DENJU-DIVISION/Tei-Board/README.md

# Tei board 帝
The Tei Board is a PCB designed mainly for minisumo robots, but it can be used for other projects or categories.\
It's a simple begginer-level PCB, uses mostly SMD components that are easy to find and solder, so it should be really simple to build.\
The processor is a Arduino Nano, and the motor driver is the TB6612FNG both very cheap and easy to find components.\
It's designed to support up to 15V but we recomend using a maximum of 3S batteries.\
This board is perfect for those just starting in robotics, easy to program and has a lot of capabilities. We recommend the use of this board for amateur categories of minisumo or line followers.\
# Features
- Dedicated bluetooth pin, so you can hook up a reciever module and control your projects remotely
- Dedicated Start Module pin
- Capability to connect up to 8 sensors, 6 of them supporting both analog and digital signals (the remaining 2 only support analog inputs)
- Rotary switch to select your programs
- XT30 connector
- On/Off Switch
- M2 mounting holes for secure mounting
- XH connectors for the motors
# Photos
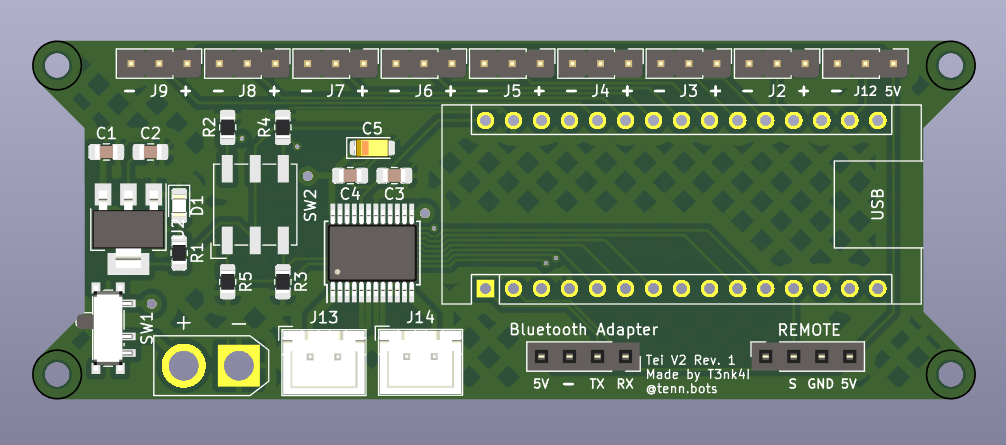
[picture p1: Tei Board front.png]

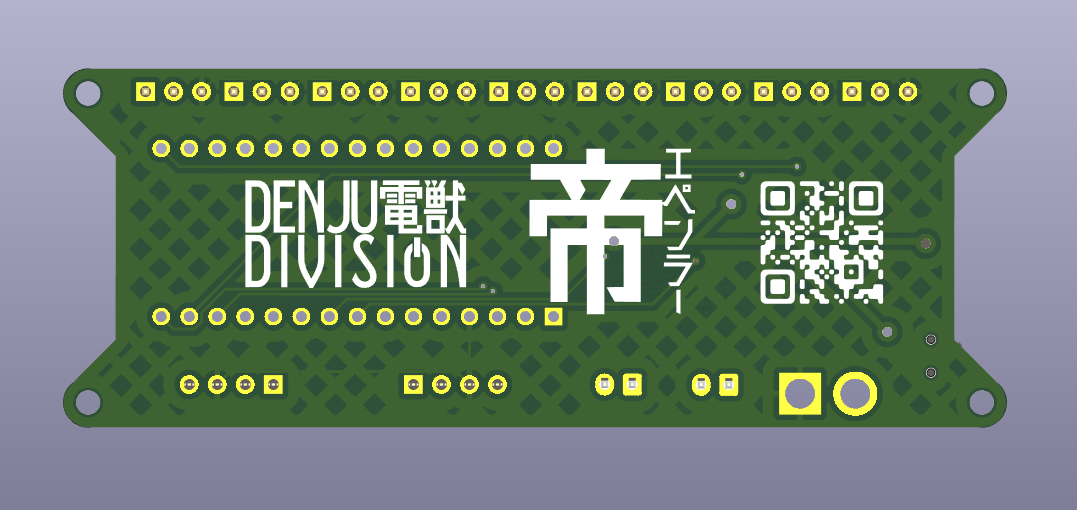
[picture p2: Tei Board back.png]
