DENJU-DIVISION/Tei-Board/Tei/Description.md

# 帝 Tei board

This is Tei (帝) Board, uses a arduino Uno and a TB6612FNG motor driver.\
Works up to 3s LiPo Batteries, (2S-3S reccomended).\
Supports up to 10 different porgrams using the included rotary coded switch.\
Example code can be found in "https://github.com/T3nk4I/Minisumo/tree/main/code/Basic".
