DENJU-DIVISION/Tei-Board/Tei/Tei.kicad_pcb

## KiCad design Tei/Tei.kicad_pcb (2025-02-03)

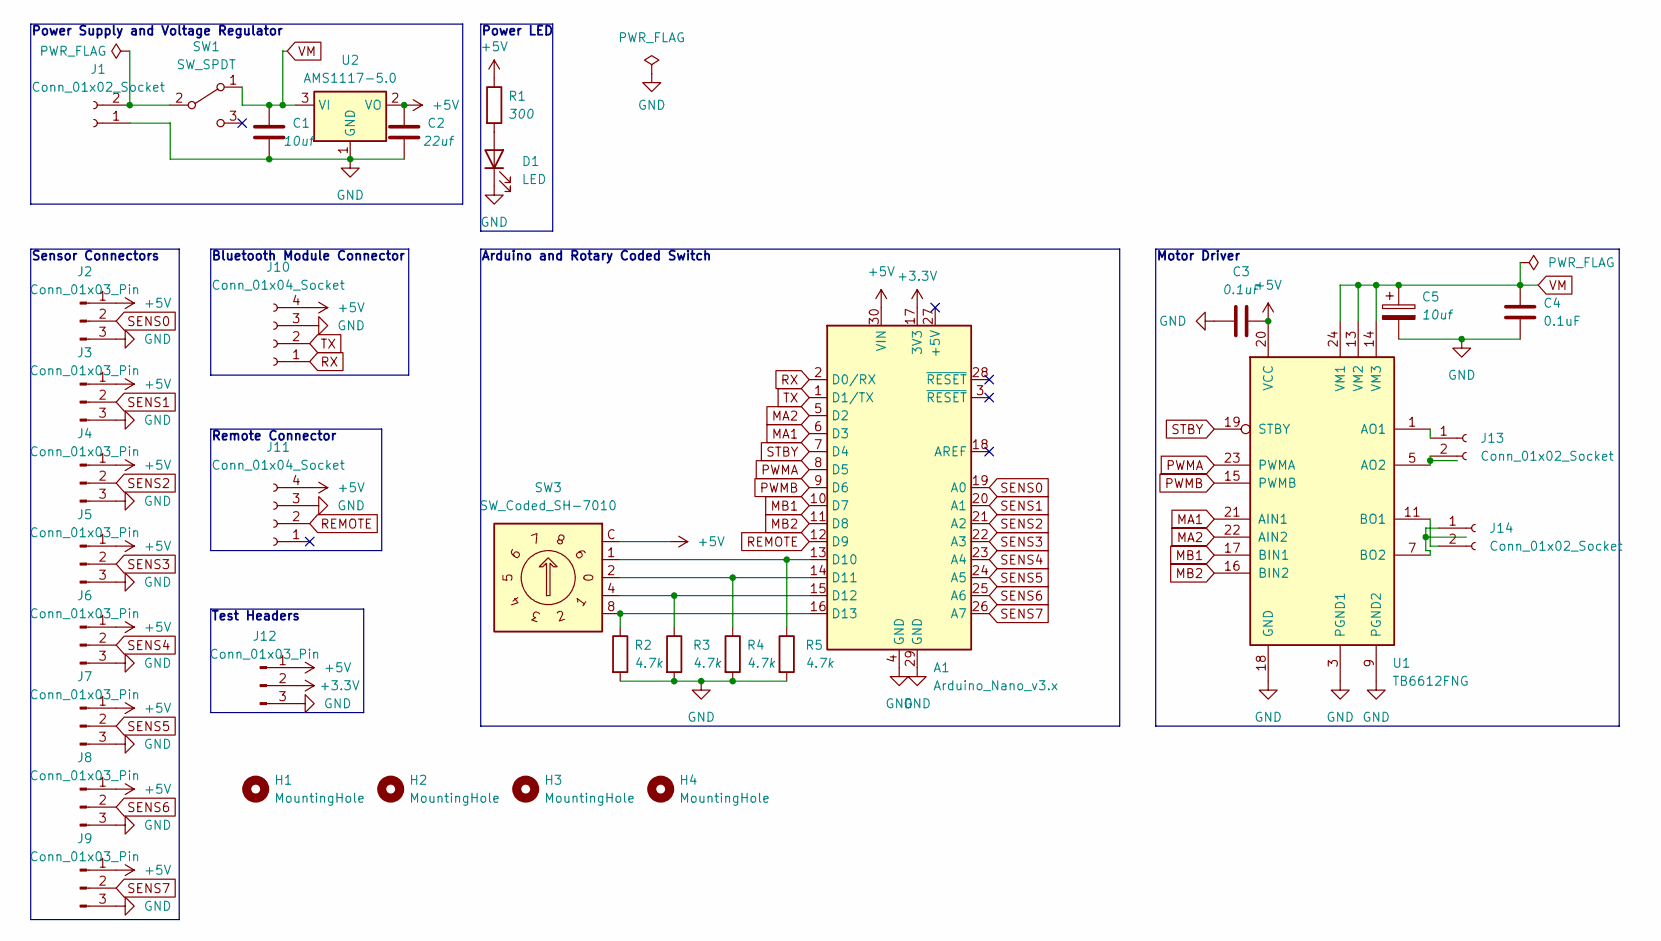
[picture p3: schematic Tei.kicad_sch, DenjuDivision_Tei_Minisumo_Board]

Parts:
A1: Arduino_Nano_v3.x; Arduino_Nano
C1: 10uf; C_0805_2012Metric_Pad1.18x1.45mm_HandSolder
C2: 22uf; C_0805_2012Metric_Pad1.18x1.45mm_HandSolder
C3, C4: 0.1uF; C_0805_2012Metric_Pad1.18x1.45mm_HandSolder
C5: 10uf; CP_EIA-3216-18_Kemet-A
D1: LED; LED_0805_2012Metric_Pad1.15x1.40mm_HandSolder
H1, H2, H3, H4: MountingHole; MountingHole_2.2mm_M2
J1: Conn_01x02_Socket; AMASS_XT30U-F_1x02_P5.0mm_Vertical
J2, J3, J4, J5, J6, J7, J8, J9, J12: Conn_01x03_Pin; PinHeader_1x03_P2.54mm_Vertical
J10, J11: Conn_01x04_Socket; PinSocket_1x04_P2.54mm_Vertical
J13, J14: Conn_01x02_Socket; JST_XH_B2B-XH-A_1x02_P2.50mm_Vertical
R1: 300; R_0805_2012Metric_Pad1.20x1.40mm_HandSolder
R2, R3, R4, R5: 4.7k; R_0805_2012Metric_Pad1.20x1.40mm_HandSolder
SW1: SW_SPDT; SW_SPDT_PCM12
SW3: SW_Coded_SH-7010; Nidec_Copal_SH-7010A
U1: TB6612FNG; SSOP-24_5.3x8.2mm_P0.65mm
U2: AMS1117-5.0; SOT-223-3_TabPin2

Connections:
+3.3V: A1.17 (3V3), J12.2
+5V: A1.30 (VIN), C2.1, C3.2, J2.1, J3.1, J4.1, J5.1, J6.1, J7.1, J8.1, J9.1, J10.4, J11.4, J12.1, R1.1, SW3.C, U1.20 (VCC), U2.2 (VO); also elsewhere on the board
GND: A1.4 (GND), A1.29 (GND), C1.2, C2.2, C3.1, C4.1, C5.2, D1.1 (K), J1.1, J2.3, J3.3, J4.3, J5.3, J6.3, J7.3, J8.3, J9.3, J10.3, J11.3, J12.3, R2.2, R3.2, R4.2, R5.2, U1.3 (PGND1), U1.4 (PGND1), U1.9 (PGND2), U1.10 (PGND2), U1.18 (GND), U2.1 (GND); also elsewhere on the board
MA1: A1.6 (D3), U1.21 (AIN1)
MA2: A1.5 (D2), U1.22 (AIN2)
MB1: A1.10 (D7), U1.17 (BIN1)
MB2: A1.11 (D8), U1.16 (BIN2)
unnamed 7: A1.13 (D10), R5.1, SW3.1; also elsewhere on the board
unnamed 8: A1.14 (D11), R4.1, SW3.2; also elsewhere on the board
unnamed 9: A1.15 (D12), R3.1, SW3.4; also elsewhere on the board
unnamed 10: A1.16 (D13), R2.1, SW3.8; also elsewhere on the board
unnamed: D1.2 (A), R1.2
unnamed: J1.2, SW1.2 (B)
unnamed: J13.1, U1.1 (AO1), U1.2 (AO1)
unnamed: J13.2, U1.5 (AO2), U1.6 (AO2)
unnamed: J14.1, U1.7 (BO2), U1.8 (BO2)
unnamed: J14.2, U1.11 (BO1), U1.12 (BO1)
PWMA: A1.8 (D5), U1.23 (PWMA)
PWMB: A1.9 (D6), U1.15 (PWMB)
REMOTE: A1.12 (D9), J11.2; also elsewhere on the board
RX: A1.2 (D0/RX), J10.1; also elsewhere on the board
SENS0: A1.19 (A0), J2.2
SENS1: A1.20 (A1), J3.2
SENS2: A1.21 (A2), J4.2
SENS3: A1.22 (A3), J5.2
SENS4: A1.23 (A4), J6.2
SENS5: A1.24 (A5), J7.2
SENS6: A1.25 (A6), J8.2
SENS7: A1.26 (A7), J9.2
STBY: A1.7 (D4), U1.19 (STBY)
TX: A1.1 (D1/TX), J10.2; also elsewhere on the board
VM: C1.1, C4.2, C5.1, SW1.1 (A), U1.13 (VM2), U1.14 (VM3), U1.24 (VM1), U2.3 (VI)

Notes on the sheet:
Remote Connector
Arduino and Rotary Coded Switch
Sensor Connectors
Test Headers
Bluetooth Module Connector
Power Supply and Voltage Regulator
Power LED
Motor Driver

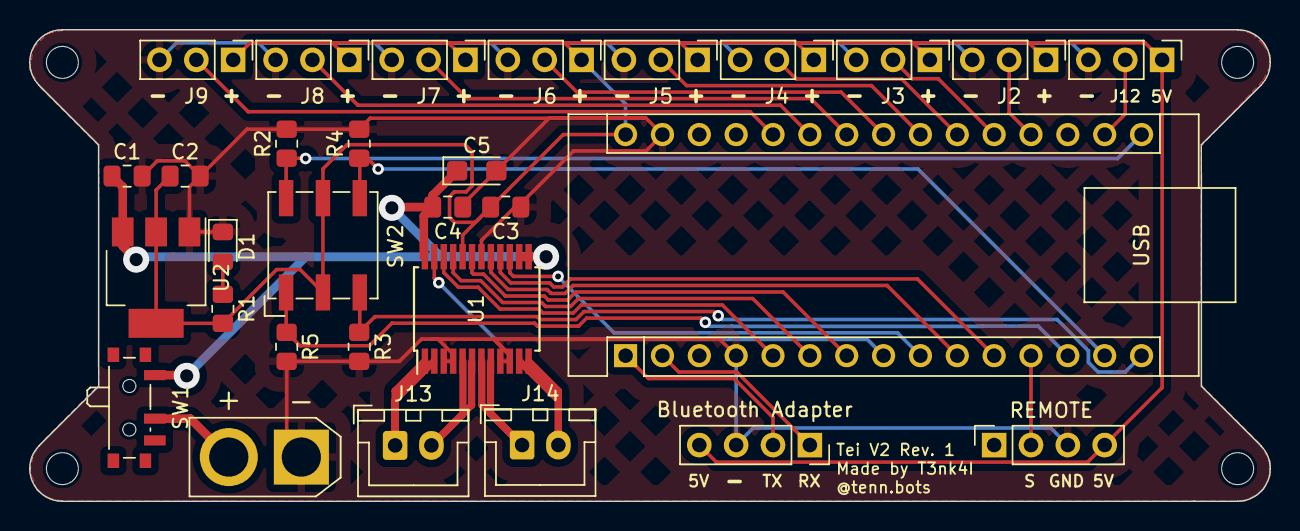
[picture p4: board Tei.kicad_pcb from above]

Board: 2 copper layers, 85.5 x 32.5 mm, 34 parts (0 on the bottom side), 32 nets.

Other parts of the board:
Bluetooth Adapter: Conn_01x04_Socket; PinSocket_1x04_P2.54mm_Vertical
REMOTE: Conn_01x04_Socket; PinSocket_1x04_P2.54mm_Vertical
SW2: SW_Coded_SH-7010; Nidec_Copal_SH-7010A

Their connections:
+5V: Bluetooth Adapter.4, REMOTE.4, SW2.C; also elsewhere on the board
GND: Bluetooth Adapter.3, REMOTE.3; also elsewhere on the board
unnamed 7: SW2.1; also elsewhere on the board
unnamed 8: SW2.2; also elsewhere on the board
unnamed 9: SW2.4; also elsewhere on the board
unnamed 10: SW2.8; also elsewhere on the board
REMOTE: REMOTE.2; also elsewhere on the board
RX: Bluetooth Adapter.1; also elsewhere on the board
TX: Bluetooth Adapter.2; also elsewhere on the board
