DENJU-DIVISION/Tei-Board/(commit log)

2025-02-03 deletes files forked from T3nk4I's minisumo repository and only keeps the files related to the tei board
    [BOM-Tei.csv, Base T4nook1.iges, Base-K1tsun3.iges, Base.stl, Chasis Gyu-Ma-Oh.iges, Chasis K1tsun3.iges, Chasis T4nook1 Jsumo-Ver.iges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]
2025-02-03 adds images of tei board for the README
2025-02-03 attaches photos in README
